fuque/PLCEXPAND/Evidencia/esp32 pinout.png

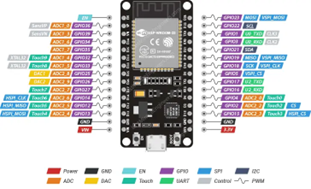
Evidencia/esp32 pinout.png
