fuque/PLCEXPAND/Evidencia/esquema final tarjeta.jpg

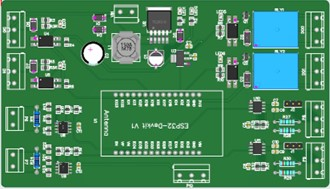
Evidencia/esquema final tarjeta.jpg
