fuque/PLCEXPAND/README.md

# PLCEXPAND
Diseño e implementación de un módulo de expansión de entradas digitales/analógicas para controlador lógico programable con comunicación modbus

Autores:

Andrés Camilo Fuquen Gil

Samir Andrés Velasco Niño

                        Escuela de Ingenierías Eléctrica, Electrónica y de Telecomunicaciones

                                          Universidad Industrial de Santander

                                                    Bucaramanga 2024
