fuque/PLCEXPAND/Entregables/Diapositivas Sustentación.pdf

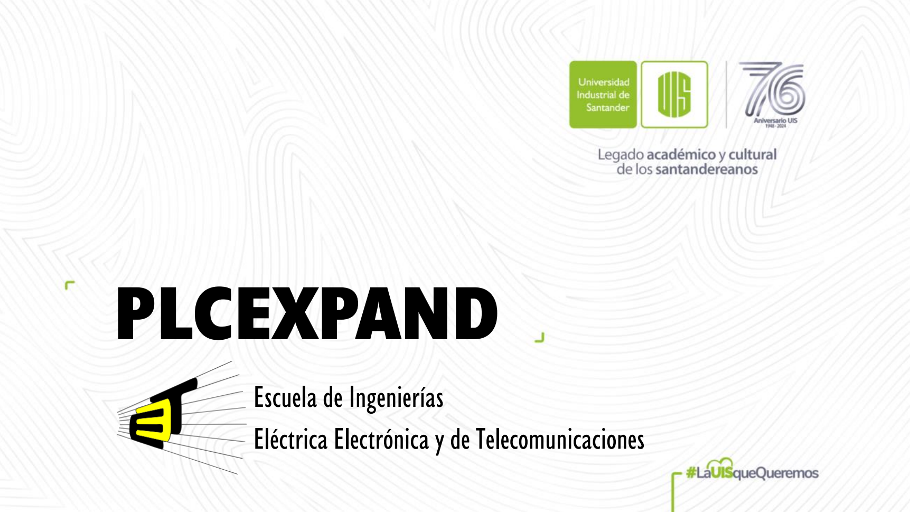
[picture p3: page 1]

# PLCEXPAND

# Escuela de Ingenierías

# Eléctrica Electrónica y de Telecomunicaciones

# AUTORES

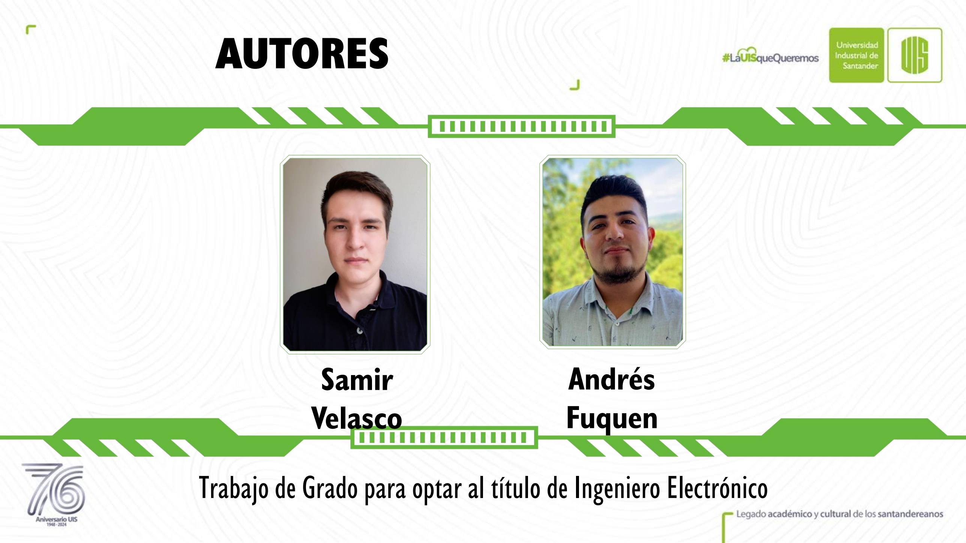
[picture p4: page 2]

# Samir Velasco

# Trabajo de Grado para optar al título de Ingeniero Electrónico

# Andrés Fuquen

# ORDEN DEL DÍA

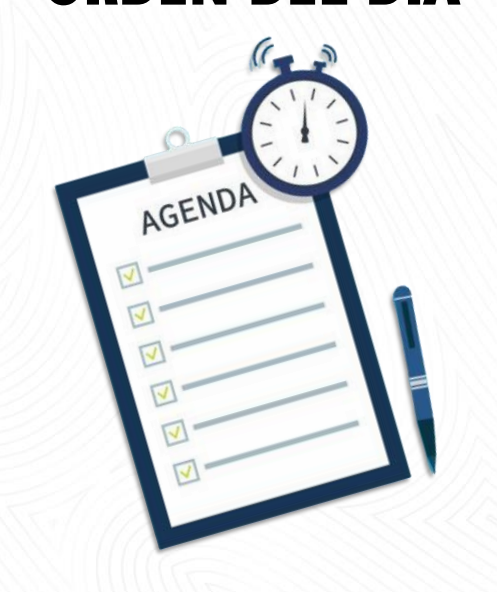
[picture p5: figure]

## - INTRODUCCÓN

## - OBJETIVO GENERAL

## - OBJETIVOS ESPECÍFICOS

## - METOLOGÍA

## - EJECUCIÓN Y RESULTADOS

## ✓ DISEÑO DE LA TARJETA ELECTÓNICA

## ✓ SELECCIÓN DE COMPONENTES

## ✓ IMPLEMENTACIÓN Y VALIDACIÓN

## - CARACTERÍSTICAS DEL COMPONENTE

## - PRESUPUESTO

## - CONCLUSIONES

## - REFERENCIAS BIBLIOGRÁFICAS

# INTRODUCCIÓN

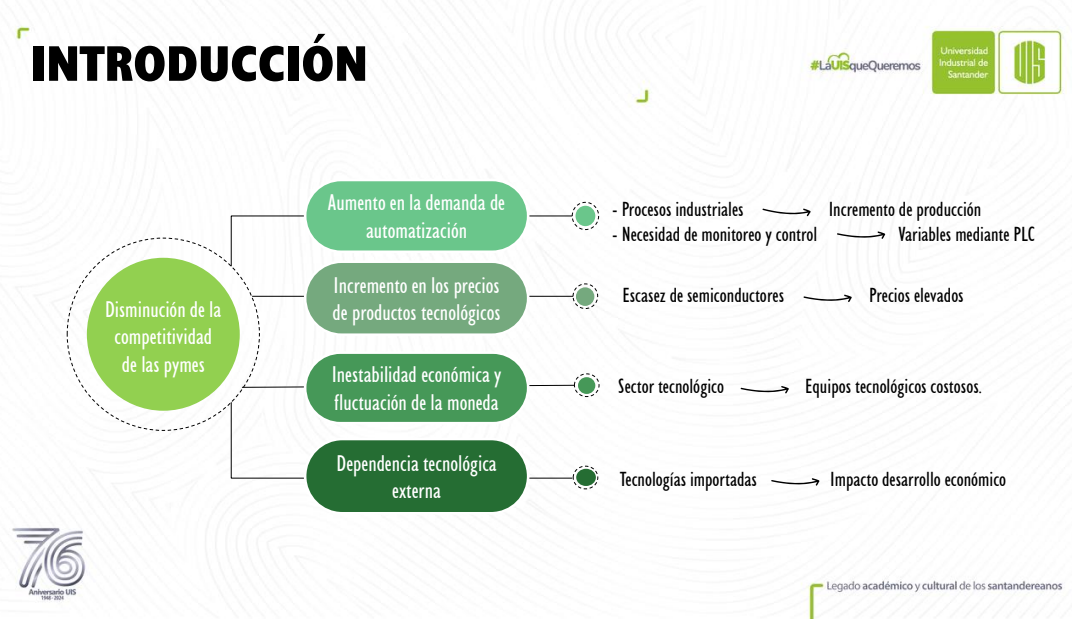
[picture p6: page 4]
Escasez de semiconductores; Precios elevados; - Procesos industriales; Incremento de producción; - Necesidad de monitoreo y control; Variables mediante PLC; Dependencia tecnológica; externa; Tecnologías importadas; Impacto desarrollo económico; Sector tecnológico; Equipos tecnológicos costosos.

Aumento en la demanda de
automatización

Incremento en los precios
de productos tecnológicos

Disminución de la
competitividad
de las pymes

Inestabilidad económica y
fluctuación de la moneda

# OBJETIVO GENERAL

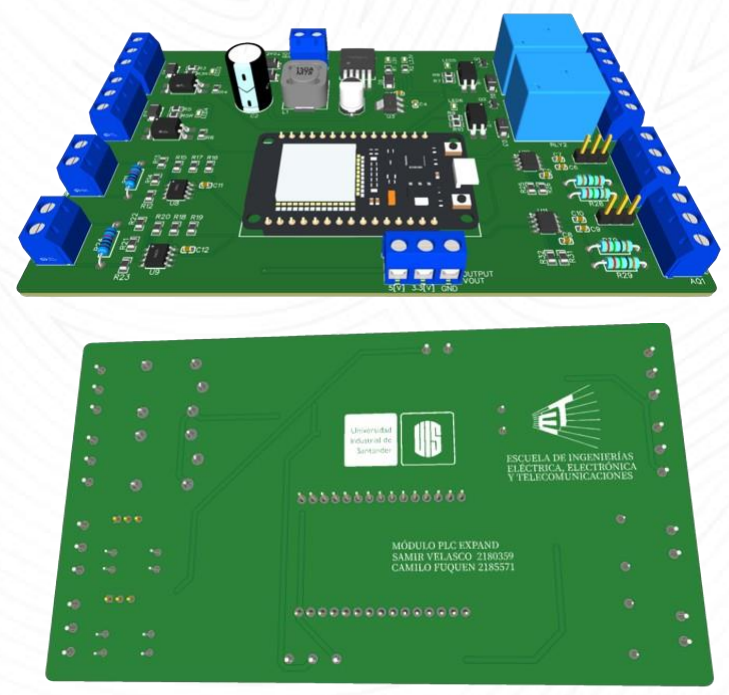
[picture p7: figure]

## Diseñar e Implementar un prototipo para la expansión de entradas digitales y analógicas para un Controlador Lógico Programable (PLC) con

comunicación Modbus.

# OBJETIVOS ESPECÍFICOS

### Diseñar un circuito electrónico basado en microcontrolador que permita

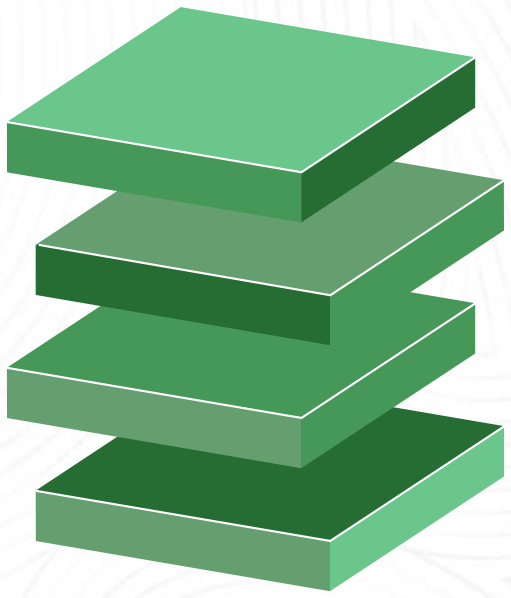
[picture p8: figure]

manejar entradas y salidas analógicas y digitales.

### Seleccionar los componentes electrónicos adecuados para la implementación de la tarjeta electrónica, basado en criterios económicos, de disponibilidad y

compatibilidad.

### Implementar, mediante MODBUS, la comunicación entre una tarjeta electrónica y un Controlador Lógico Programable (PLC) mediante el uso del

software TIA Portal.

### Validar la lectura digital/analógica con el Controlador Lógico Programable

(PLC) del módulo expansor mediante comunicación Modbus.

1

2

3

4

# METODOLOGÍA

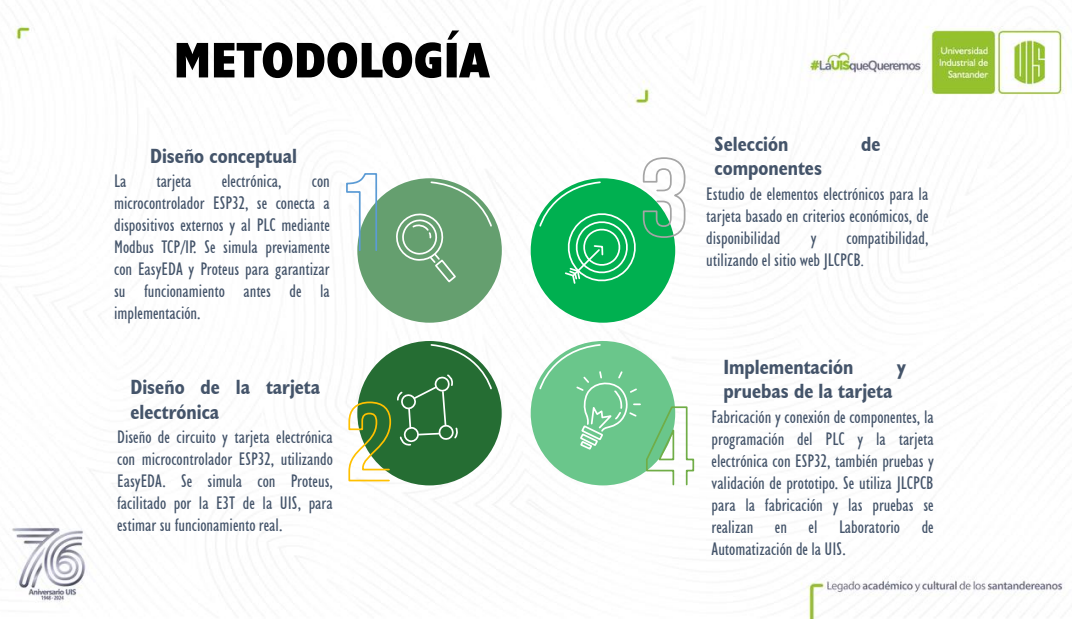
[picture p9: page 7]
tarjeta; electrónica,; con; funcionamiento; antes; y tarjeta electrónica; , utilizando; compatibilidad,; realizan; Laboratorio; Diseño conceptual; Selección

componentes
Estudio de elementos electrónicos para la
tarjeta basado en criterios económicos, de
disponibilidad
utilizando el sitio web JLCPCB

microcontrolador ESP32
dispositivos externos
Modbus TCP/IP. Se simula previamente
con EasyEDA
implementación

, se conecta
y al PLC mediante

y Proteus para garantizar

Implementación
pruebas de la tarjeta
Fabricación
programación del PLC
electrónica con ESP32
validación de prototipo
para la fabricación
Automatización de la UIS

Diseño de la tarjeta
electrónica
Diseño de circuito
con microcontrolador ESP32
EasyEDA
facilitado por la
estimar su funcionamiento real

y conexión de componentes, la

y la tarjeta
, también pruebas
. Se utiliza JLCPCB
y las pruebas se

. Se simula con Proteus,

T de la UIS, para

# EJECUCIÓN Y RESULTADOS

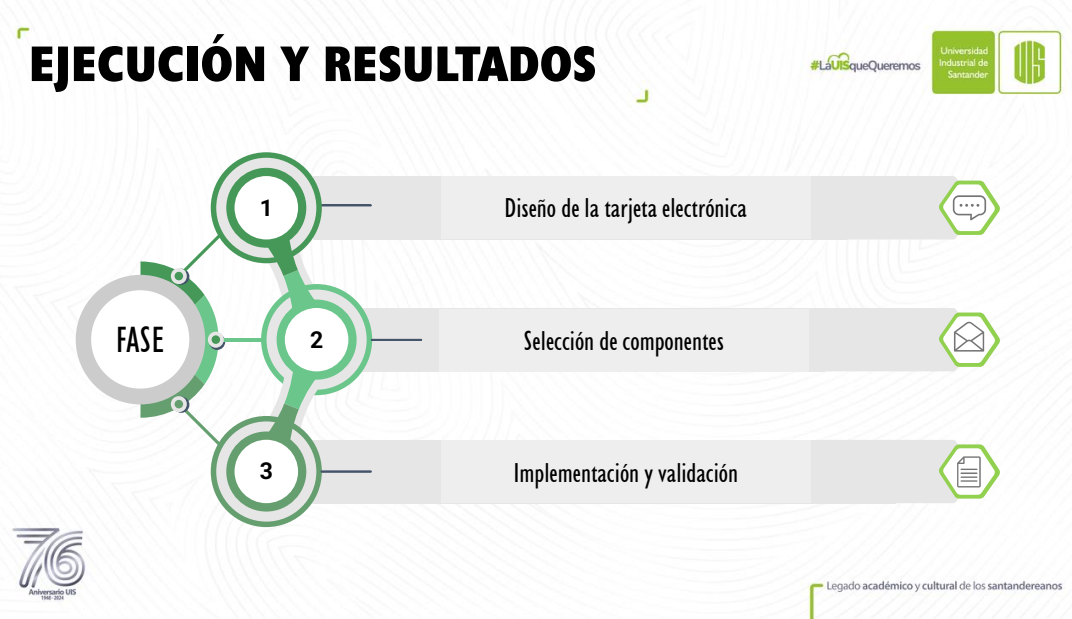
[picture p10: page 8]
3 Implementación y validación; FASE

Diseño de la tarjeta electrónica

Selección de componentes

DISEÑO | DE | LA | TARJETA

# ELECTRÓNICA

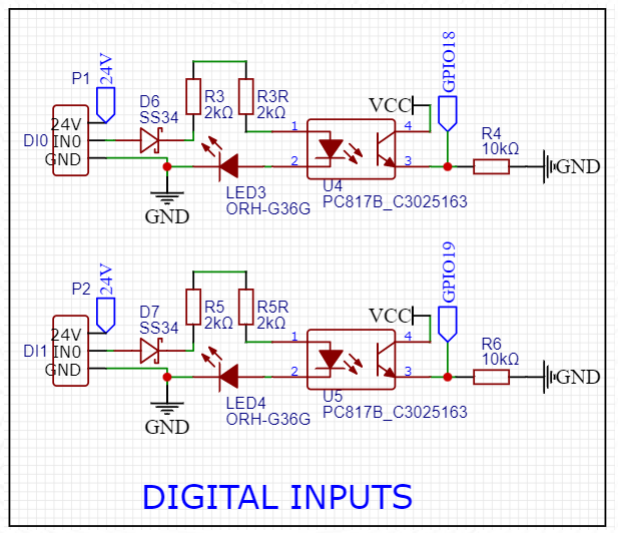
[picture p11: figure]
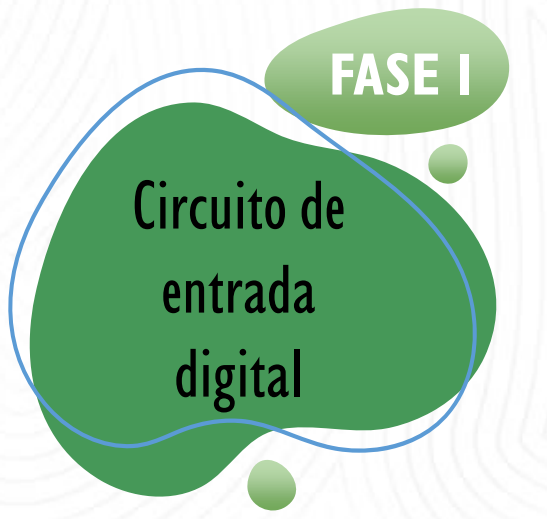
[picture p12: figure]
FASE 1; Circuito de; entrada; digital

DISEÑO | DE | LA | TARJETA

# ELECTRÓNICA

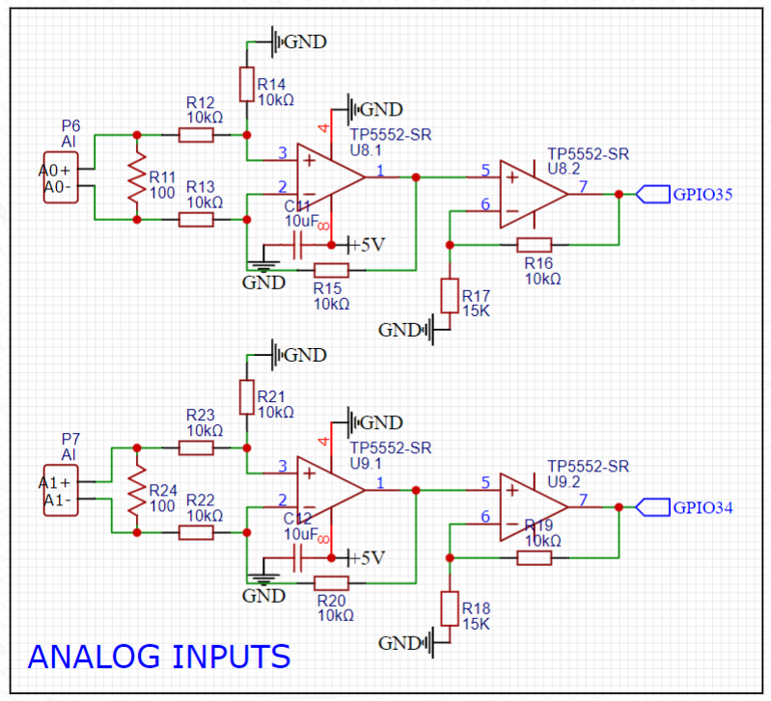
[picture p13: figure]
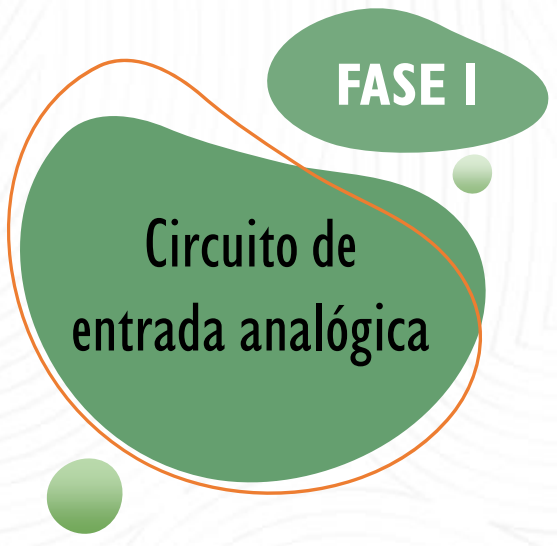
[picture p14: figure]
FASE 1; Circuito de; entrada analógica

DISEÑO | DE | LA | TARJETA

# ELECTRÓNICA

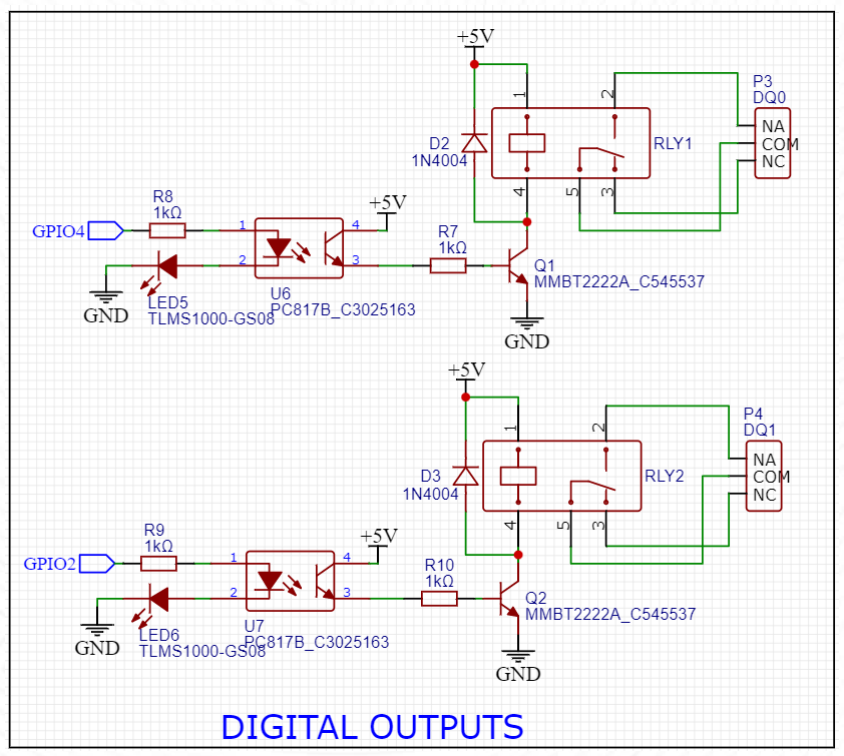
[picture p15: figure]
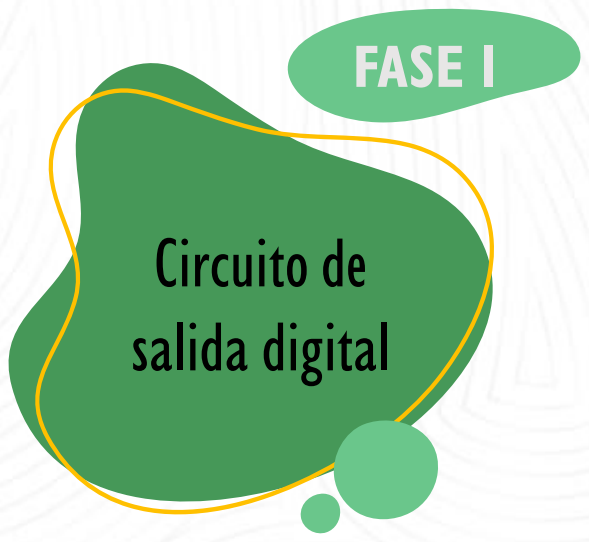
[picture p16: figure]
FASE 1; Circuito de; salida digital

DISEÑO | DE | LA | TARJETA

# ELECTRÓNICA

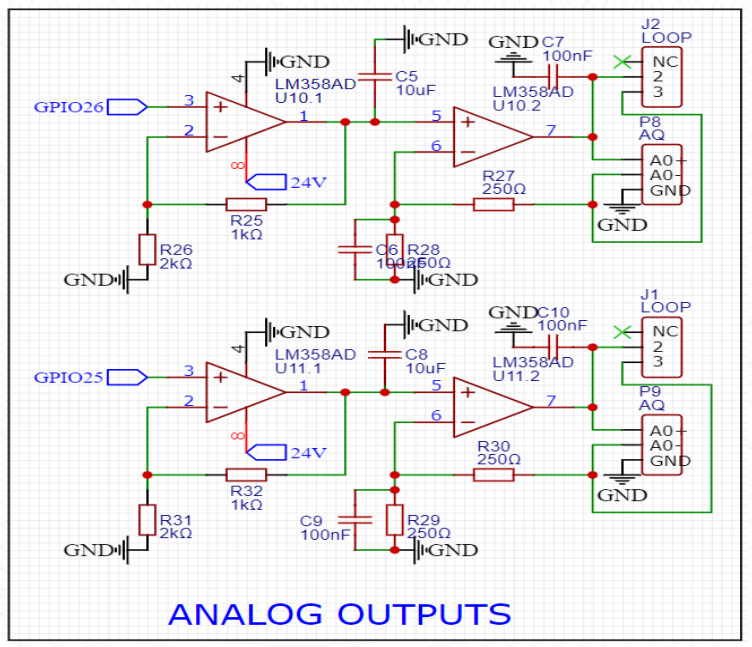
[picture p17: figure]
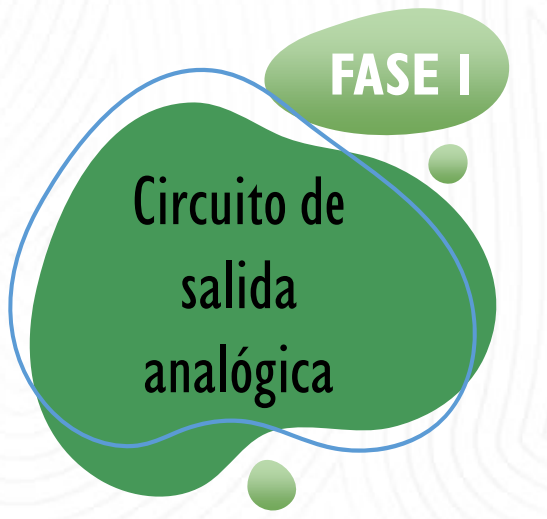
[picture p18: figure]
FASE 1; Circuito de; salida; analógica

DISEÑO | DE | LA | TARJETA

# ELECTRÓNICA

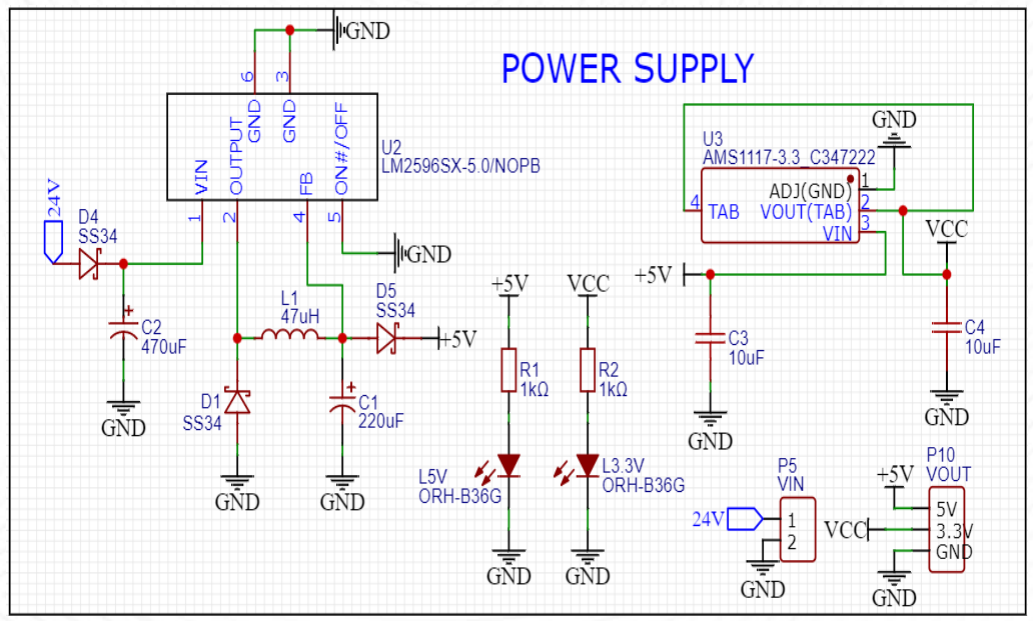
[picture p19: figure]
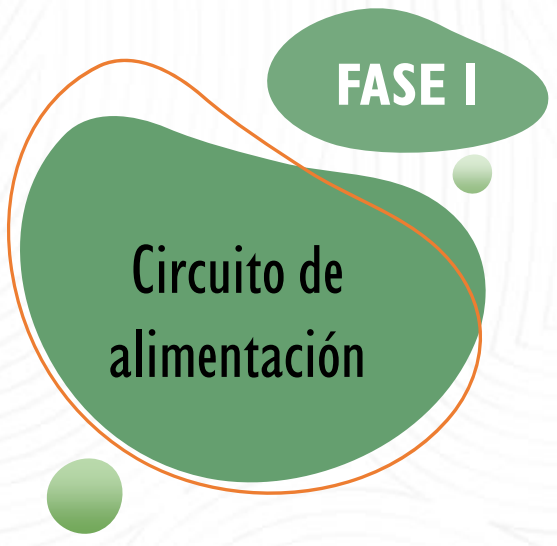
[picture p20: figure]
FASE 1; Circuito de; alimentación

# SELECCIÓN DE COMPONENTES

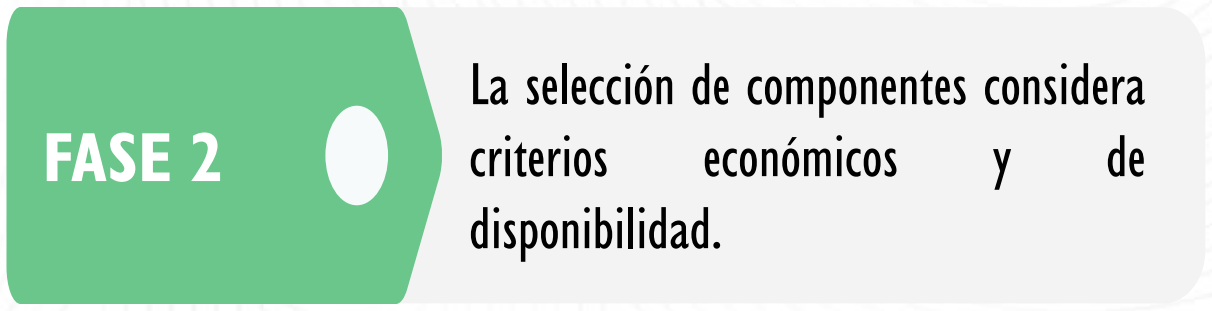
[picture p21: figure]
FASE 2; La selección de componentes considera; criterios; económicos; disponibilidad.

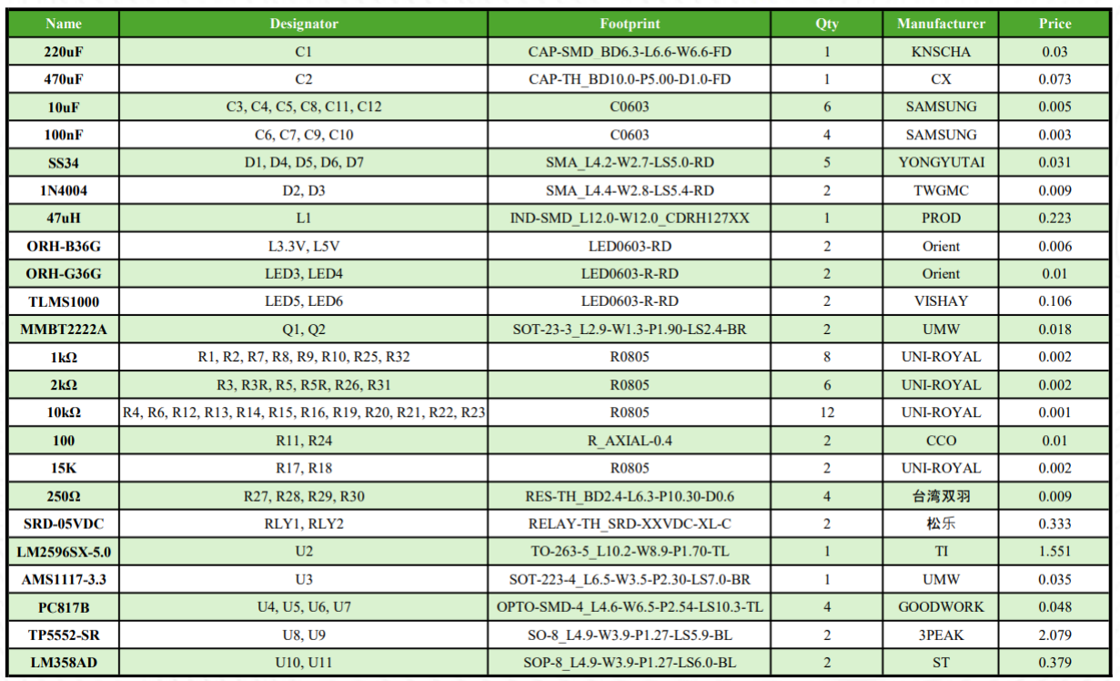
[picture p22: figure]

# IMPLEMENTACIÓN Y VALIDACIÓN

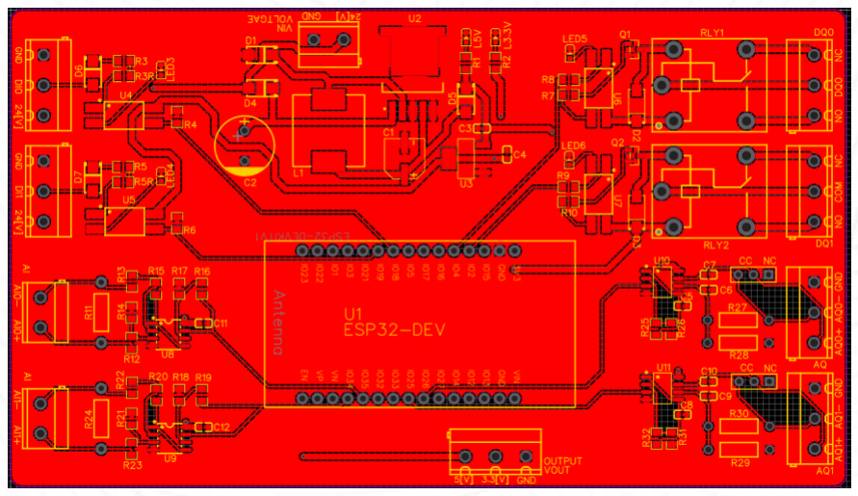
[picture p23: figure]
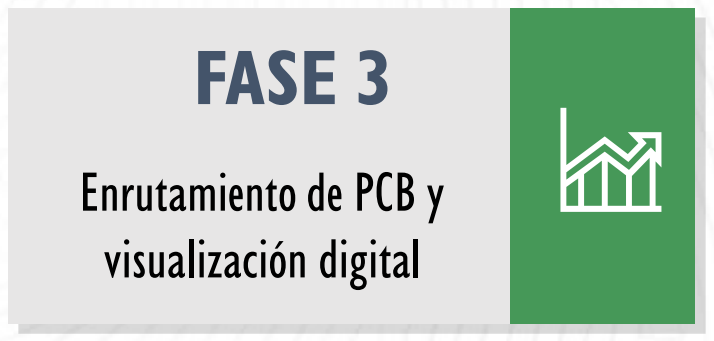
[picture p24: figure]
Enrutamiento de PCB y; visualización digital; FASE 3
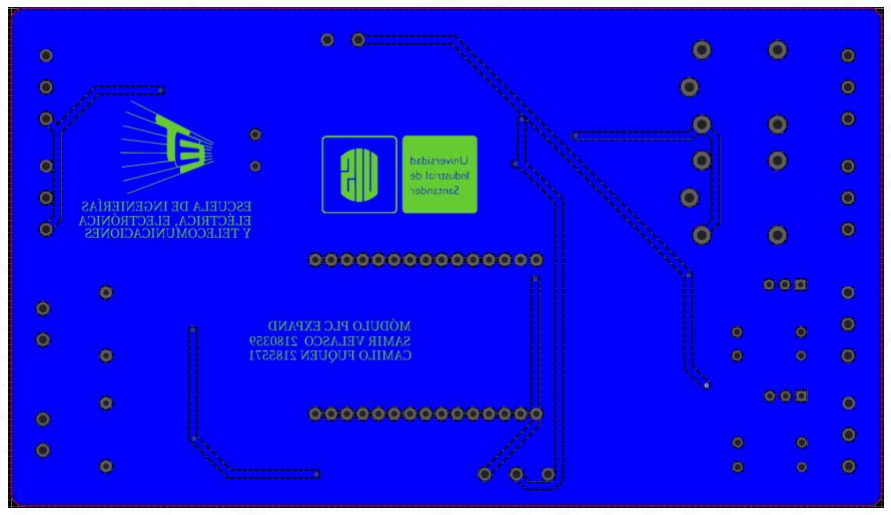
[picture p25: figure]

# IMPLEMENTACIÓN Y VALIDACIÓN

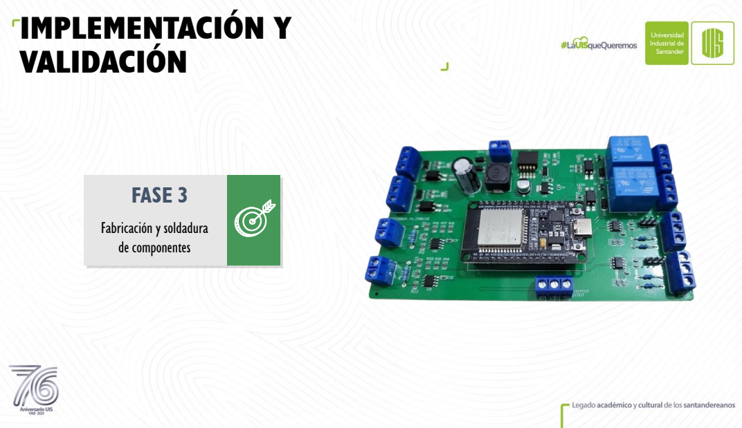
[picture p26: page 17]
Fabricación y soldadura; de componentes; FASE 3

# IMPLEMENTACIÓN Y VALIDACIÓN

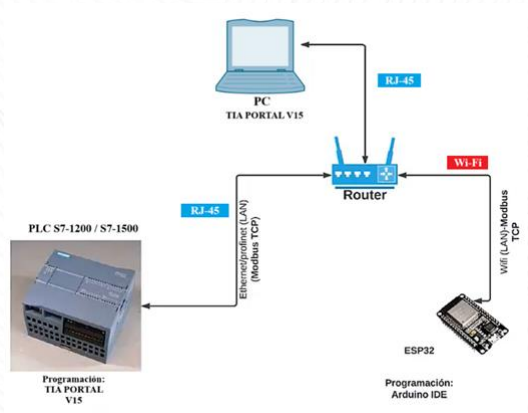
[picture p27: figure]
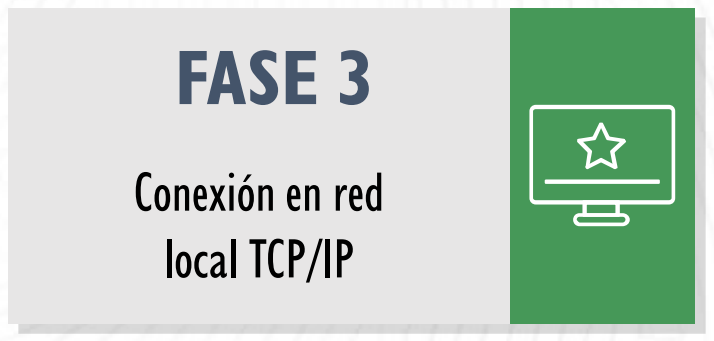
[picture p28: figure]
Conexión en red; local TCP/IP; FASE 3

# IMPLEMENTACIÓN Y VALIDACIÓN

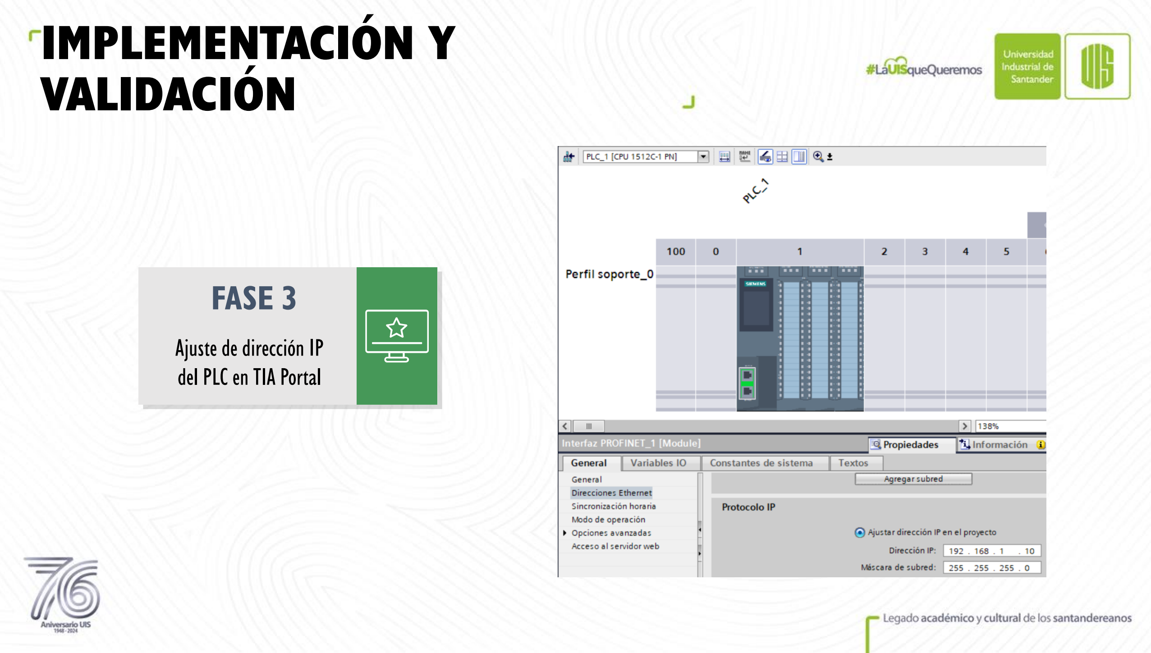
[picture p29: page 19]

### Ajuste de dirección IP

### del PLC en TIA Portal

## FASE 3

# IMPLEMENTACIÓN Y VALIDACIÓN

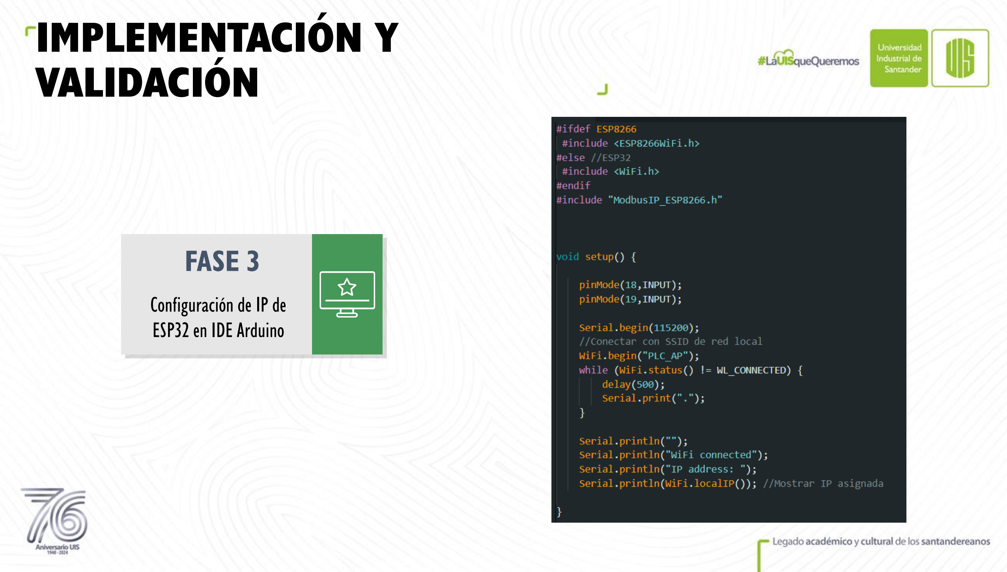
[picture p30: page 20]

### Configuración de IP de

### ESP32 en IDE Arduino

## FASE 3

# IMPLEMENTACIÓN Y VALIDACIÓN

### Ajuste de dirección IP

### del PLC en TIA Portal

## FASE 3

# IMPLEMENTACIÓN Y VALIDACIÓN

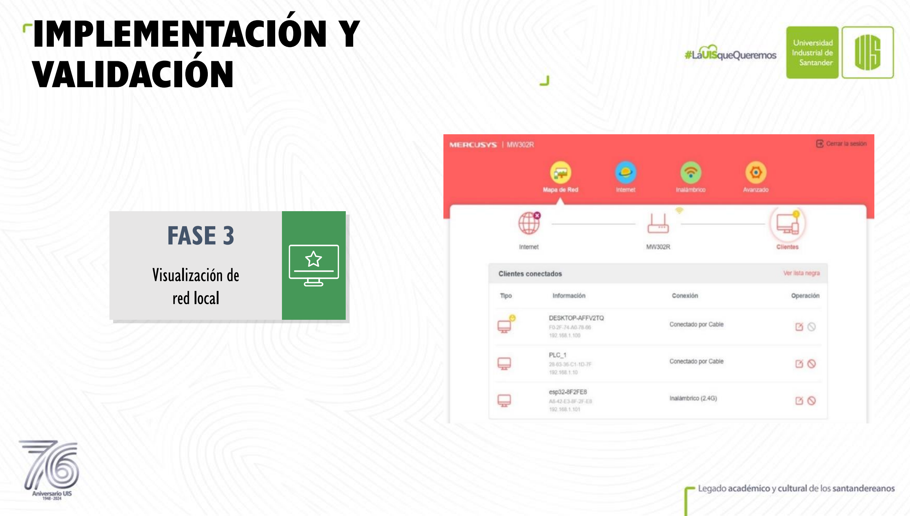
[picture p31: page 22]

### Visualización de red local

## FASE 3

# IMPLEMENTACIÓN Y VALIDACIÓN

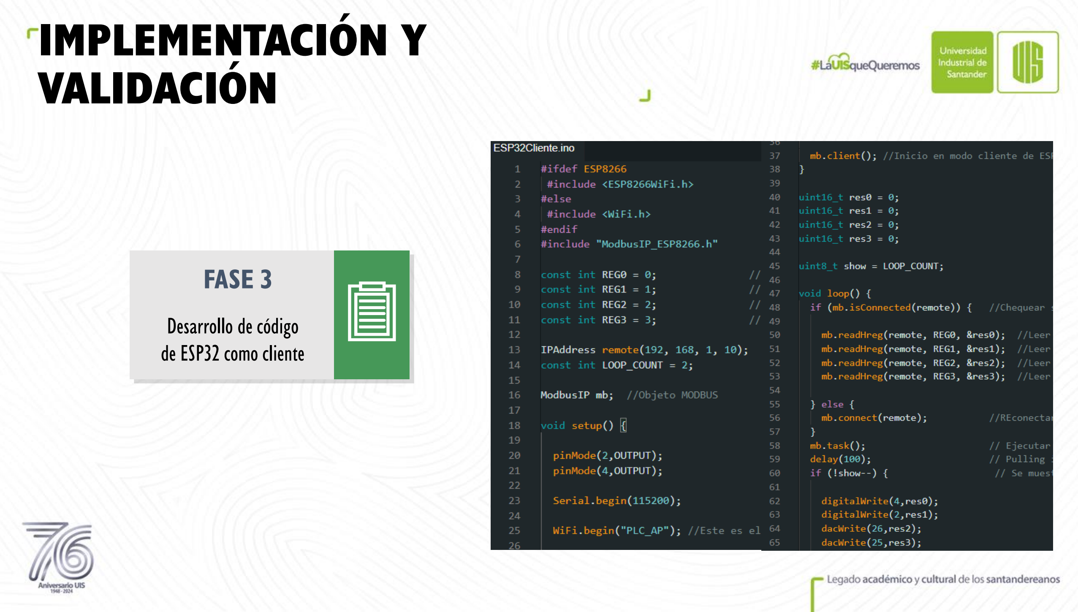
[picture p32: page 23]

### Desarrollo de código de ESP32 como cliente

## FASE 3

# IMPLEMENTACIÓN Y VALIDACIÓN

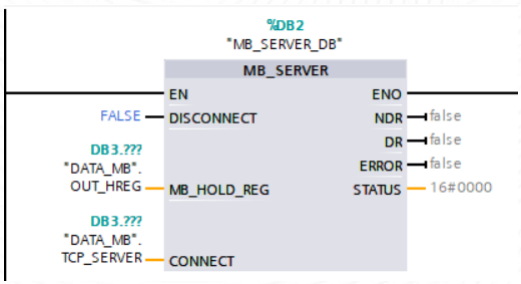
[picture p33: figure]
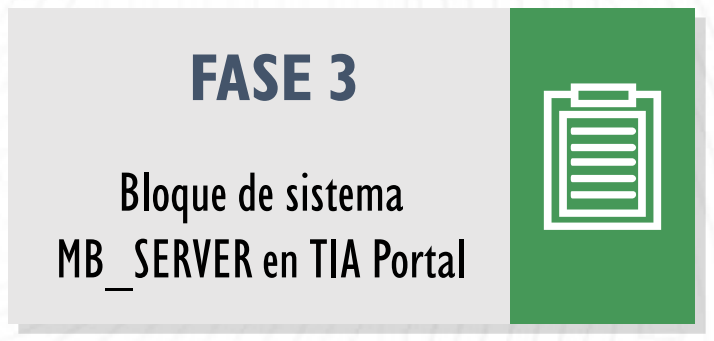
[picture p34: figure]
Bloque de sistema; MB_SERVER en TIA Portal; FASE 3

# IMPLEMENTACIÓN Y VALIDACIÓN

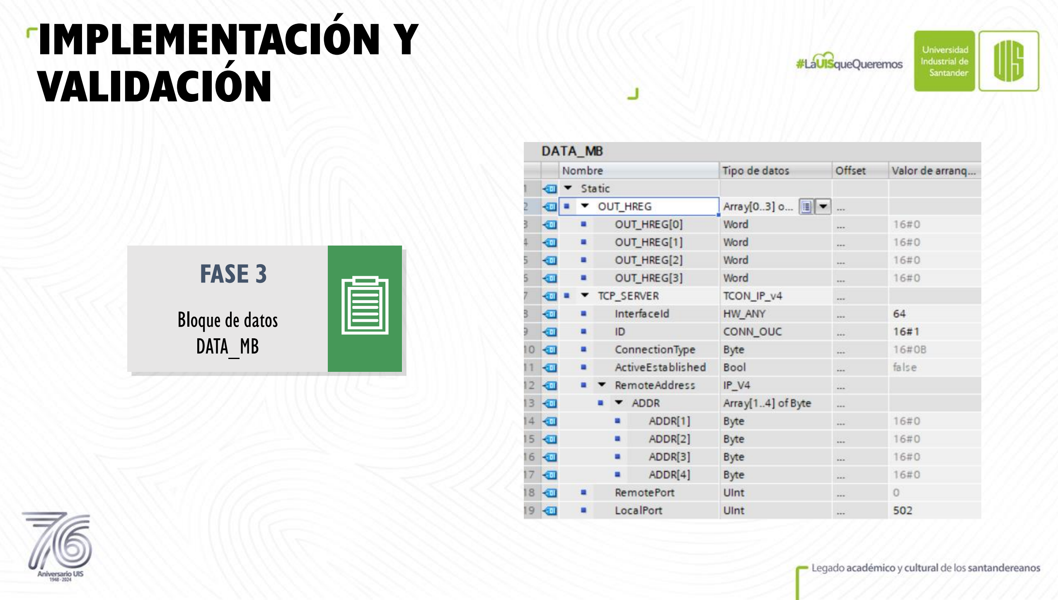
[picture p35: page 25]

### Bloque de datos

### DATA_MB

## FASE 3

# IMPLEMENTACIÓN Y VALIDACIÓN

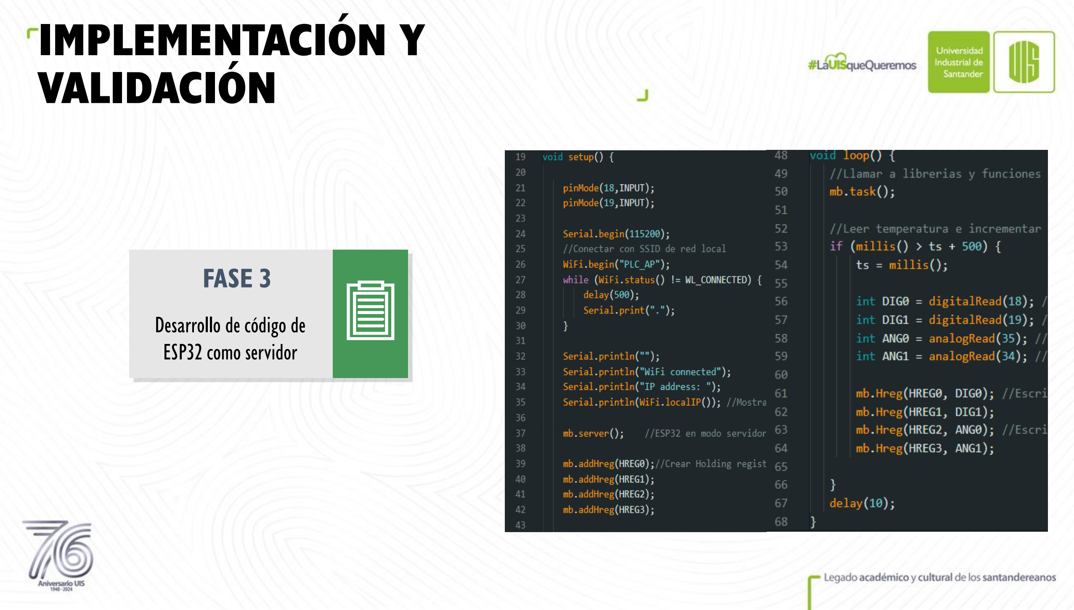
[picture p36: page 26]

### Desarrollo de código de ESP32 como servidor

## FASE 3

# IMPLEMENTACIÓN Y VALIDACIÓN

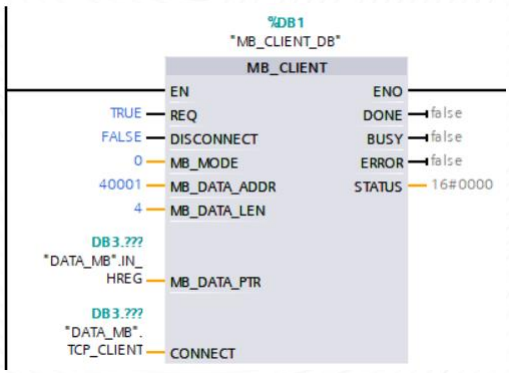
[picture p37: figure]
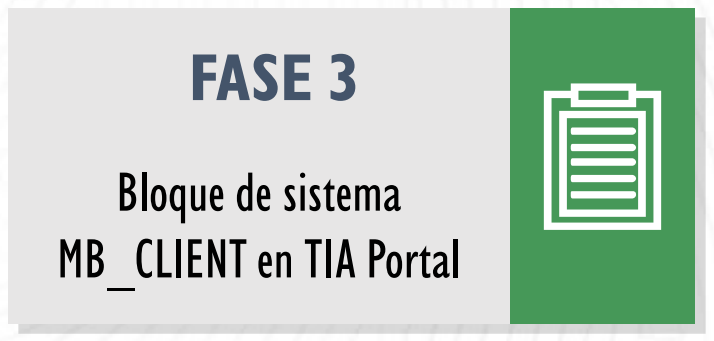
[picture p38: figure]
Bloque de sistema; MB_CLIENT en TIA Portal; FASE 3

# IMPLEMENTACIÓN Y VALIDACIÓN

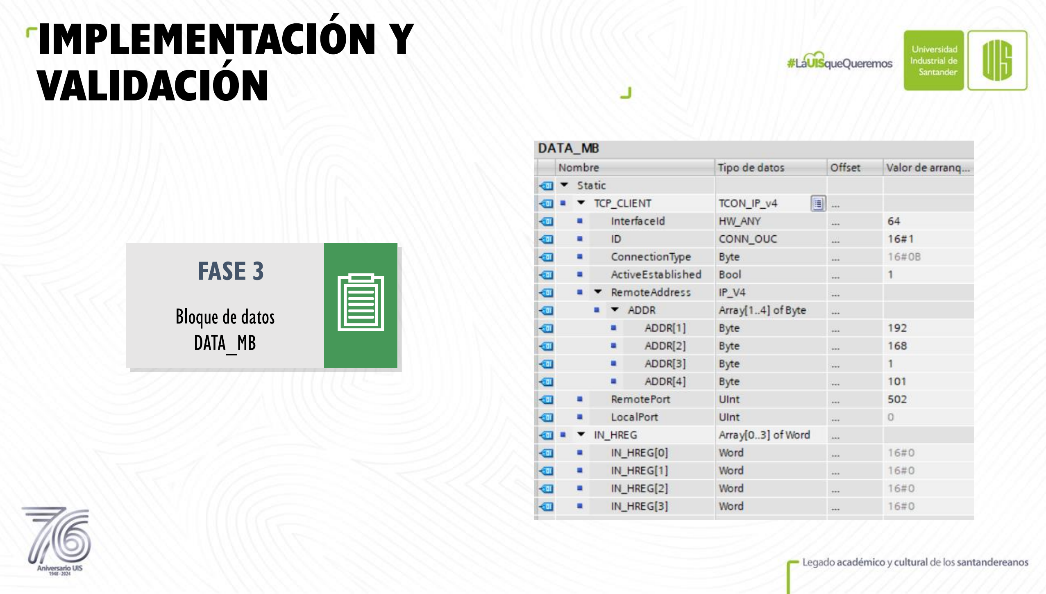
[picture p39: page 28]

### Bloque de datos

### DATA_MB

## FASE 3

# IMPLEMENTACIÓN Y VALIDACIÓN

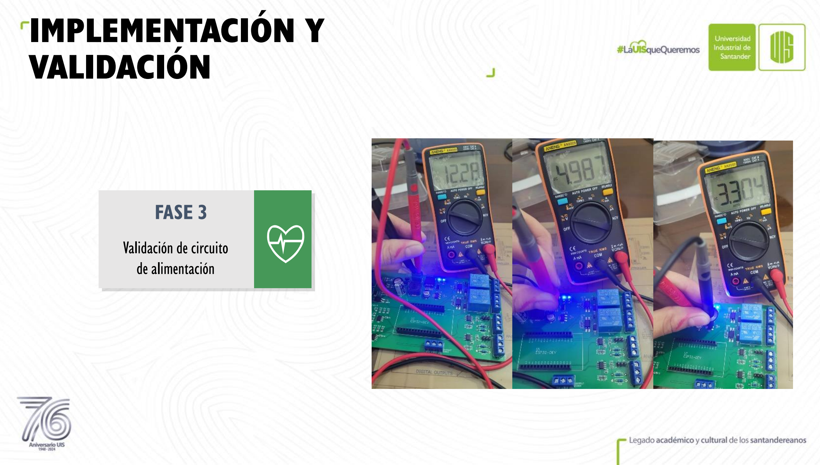
[picture p40: page 29]

### Validación de circuito de alimentación

## FASE 3

# IMPLEMENTACIÓN Y VALIDACIÓN

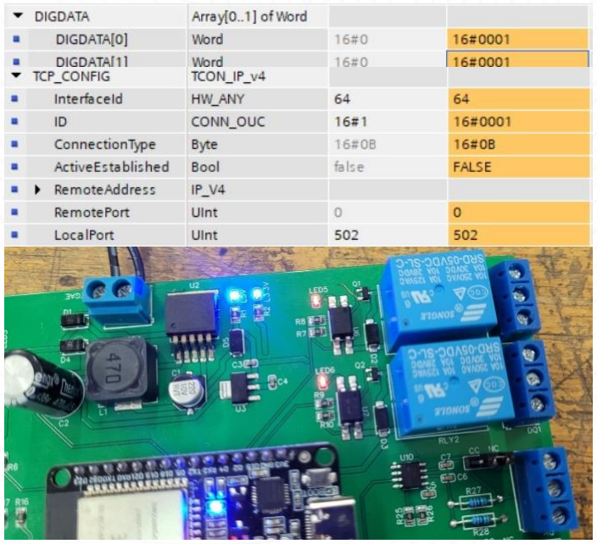
[picture p41: figure]
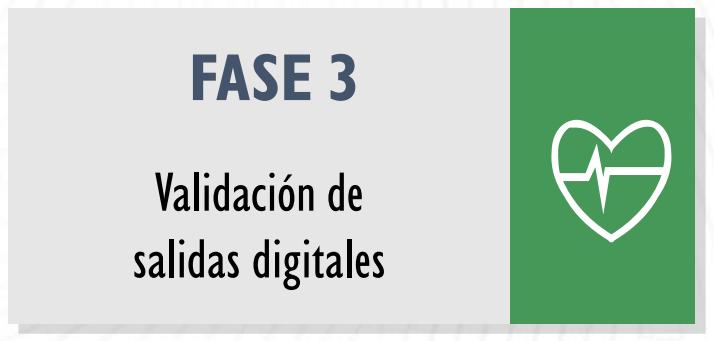
[picture p42: figure]
Validación de; salidas digitales; FASE 3

# IMPLEMENTACIÓN Y VALIDACIÓN

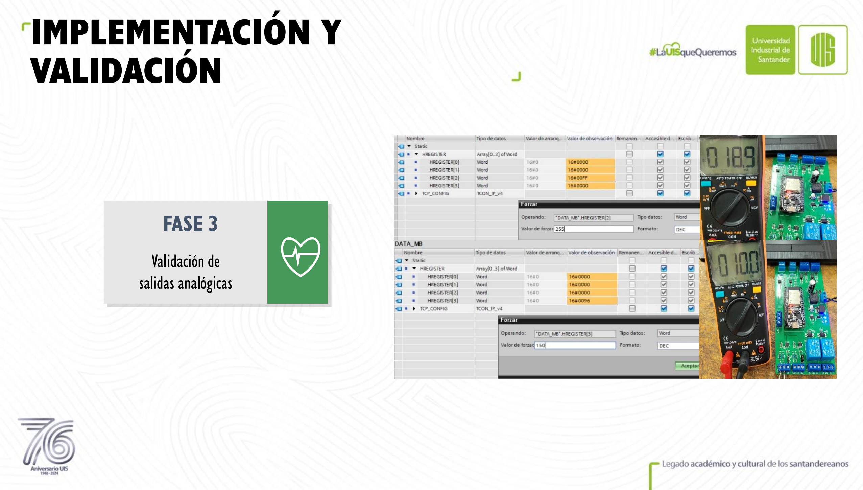
[picture p43: page 31]

### Validación de salidas analógicas

## FASE 3

# IMPLEMENTACIÓN Y VALIDACIÓN

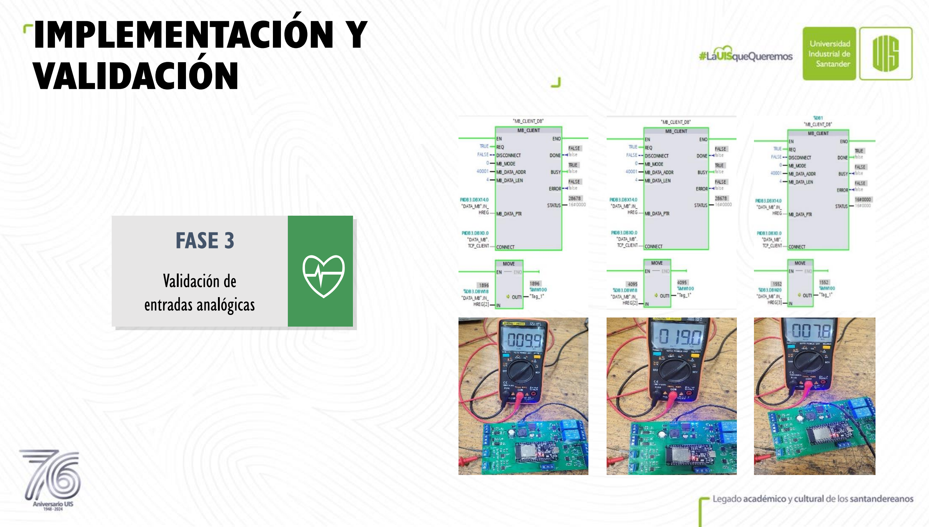
[picture p44: page 32]

### Validación de entradas analógicas

## FASE 3

# IMPLEMENTACIÓN Y VALIDACIÓN

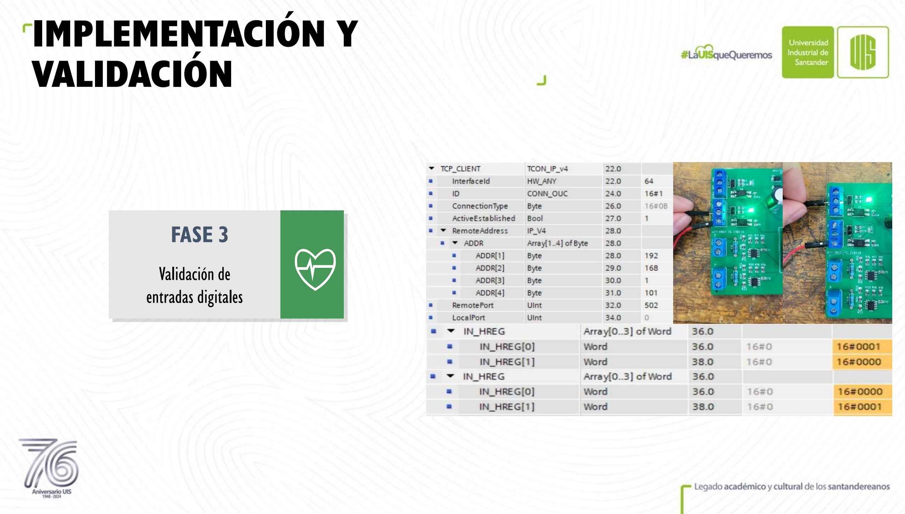
[picture p45: page 33]

### Validación de entradas digitales

## FASE 3

# CARACTERÍSTICAS DEL COMPONENTE

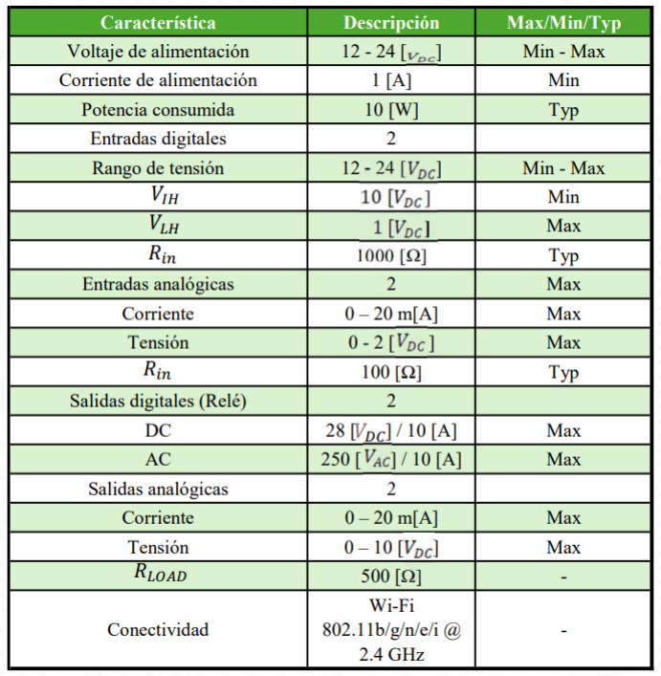
[picture p46: figure]

# PRESUPUESTO

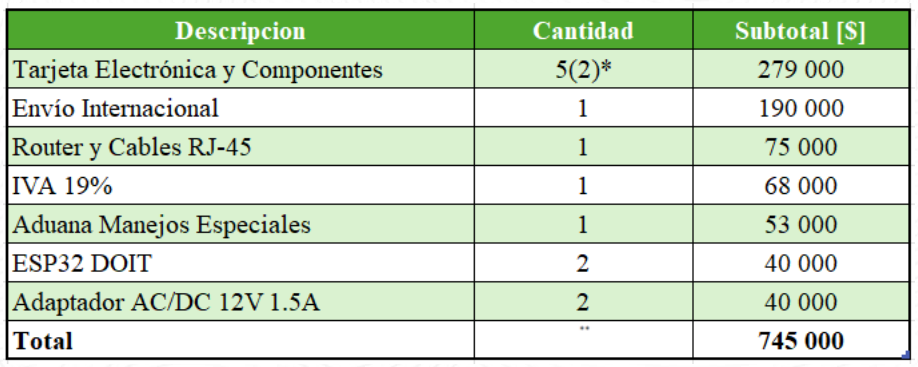
[picture p47: figure]

# CONCLUSIONES

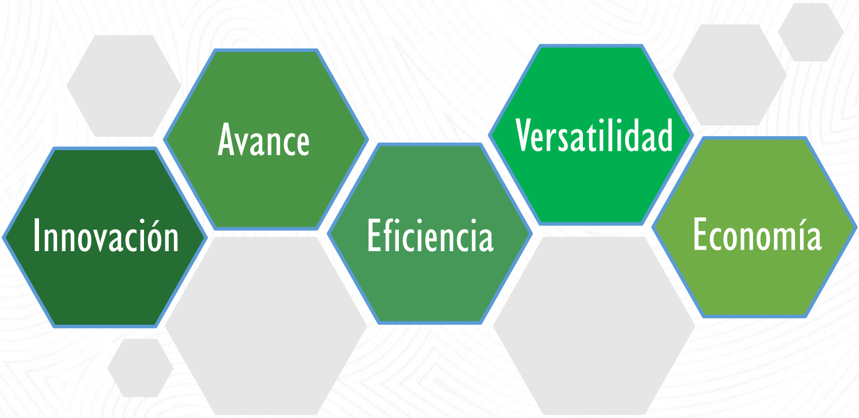
[picture p48: figure]
Eficiencia; Avance; Innovación; Versatilidad; Economía

# REFERENCIAS BIBLIOGRÁFICAS

Acosta, J. (5 de Noviembre de 2023). La resistencia a la reindustrialización para el desarrollo. Obtenido de Razón Pública: https://razonpublica.com/la-resistencia-la-reindustrializacion-

desarrollo/

Arduino. (2024). Software | Arduino. Obtenidode https://www.arduino.cc/en/software
Bolton, | W. | (2015). | Programmable | Logic | Controllers | (Sixth | Edition | ed.). | Oxford: | Elsevier. | Obtenido | de

https://www.academia.edu/94987128/William_Bolton_Programmable_Logic_Controllers_Sixth_Edition_Newnes_2015_

Borja Calvo, L. (2019). Adquisición de datos desde plataforma IOT2040. Protocolos Modbus/TCP y OPC UA. Universidad del País Vasco: Tesis de grado. Obtenido de

https://addi.ehu.es/bitstream/handle/10810/36491/TFG-%20Borja%20Calvo.pdf?sequence=2&isAllowed=y

Cajamarca, I. (13 de Noviembre de 2021). Industrias estarán frenadas hasta 2023 ante la crisis generada por la escasez de chips. Obtenido de Diario la República:

https://www.larepublica.co/internet-economy/industrias-estaran-frenadas-hasta-2023-ante-la-crisis-generada-por-la-escasez-de-chips-3261411

Creus, A. (2010). Instrumentación Industrial (octavaedicióned.).Alfaomega Grupo Editor S.A.

EasyEDA. (2024). Simuladorde circuitos ydiseño de circuitos impresos online. Obtenido dehttps://easyeda.com/es

Electrónico, T. (15 de Marzo de 2022). Comunicación MODBUS TCP(Servidor-Cliente) entrePLC Siemens S7-1200 yESP32. Obtenidode YouTube: https://youtu.be/CzEdDJVsmAM

Emelianov. (2024). Most complete Modbus library forArduino. Obtenido de GitHub: https://github.com/emelianov/modbus-esp8266

Espressif Systems. (2024). ESP32 Wi-Fi & BluetoothSOC. Obtenido dehttps://www.espressif.com/en/products/socs/esp32

IPSON.nl. (s.f.). Opamp basics - Technology forArt and Education. Obtenido de https://www.ipson.nl/opamp-circuit-examples/

JLCPCB. (2024).PCB Prototype & PCB Fabrication Manufacturer - JLCPCB. Obtenido de https://jlcpcb.com/

Joan. (2024). Tutorial del optoacoplador con circuito deE/S. Obtenido de Electrónica Joan: https://electrojoan.com/tutorial-del-optoacoplador-con-circuito-de-e-s/

Labcenter Electronics. (2024). PCB Design and Circuit Simulator Software -Proteus. Obtenido de https://www.labcenter.com/

Lesmes, L. (31 de Enero de 2022). El impacto de la crisis de contenedores podría ir hasta 2023. Obtenido de Revista Portafolio: https://www.portafolio.co/revista-portafolio/el-

impacto-de-la-crisis-de-contenedores-podria-ir-hasta-2023-561156

Mandado, E., Acevedo, J. M., Fernandez, C., & Armesto, J. (2009). Autómatas programables y sistemas de automatización. MARCOMBO, S.A. Obtenido de

https://www.academia.edu/43582464/Automatas_Programables_y_Sistemas_de_Automatizacion_Parte

MERCUSYS Technologies Co. (2024). Welcome to MERCUSYS. Obtenido de https://www.mercusys.com/co/

Mordor Intelligence. (2024). Mercado PLC. Obtenido de Mordor Intelligence: https://www.mordorintelligence.com/es/industry-reports/programmable-logic-

controller-plc-market

Sanchis, R., Romero, J., & Ariño, C. (2010). Automatización Industrial. España: Publicaciones de la Universitat Jaume I.

Schneider | Electric. | (2020). | Funciones | TCP/IP | Modbus. | Obtenido | de | Schneider | Electric: | https://product-help.schneider-

electric.com/ED/PowerTag/Smartlink_SIB/EDMS/DOCA0123ES/DOCA0123xx/Details_of_Modbus_Functions/Details_of_Modbus_Functions-

2.htm#XREF_D_SE_0060560_1

Siemens. (2024). TIA Portal - Siemens Global. Obtenido de https://www.siemens.com/global/en/products/automation/industry-software/automation-

software/tia-portal.html

WiAutomation. (2024). WiAutomation | Proveedorde repuestos de automatización. Obtenido de https://co.wiautomation.com/

https://www.freepik.com/

https://slidesgo.com/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

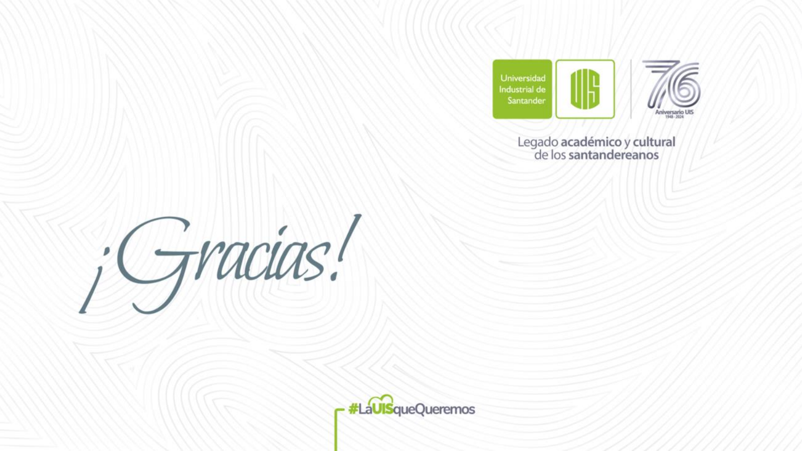
[picture p49: page 40]
