fuque/PLCEXPAND/Cálculos para pistas/ancho minimo.jpg

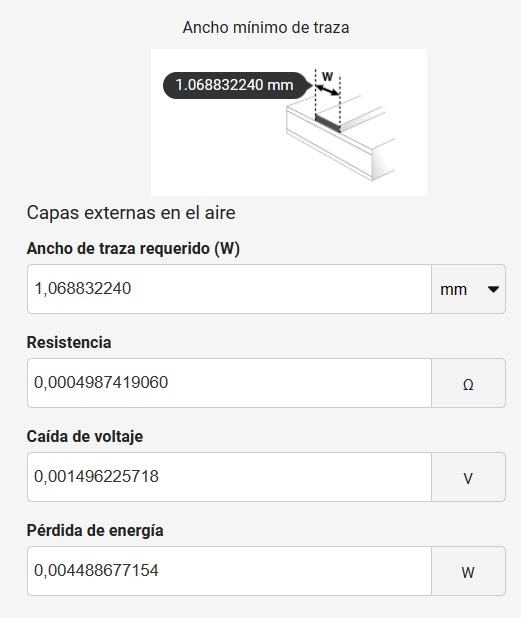
Cálculos para pistas/ancho minimo.jpg
