fuque/PLCEXPAND/Cálculos para pistas/espesor y longitud.jpg

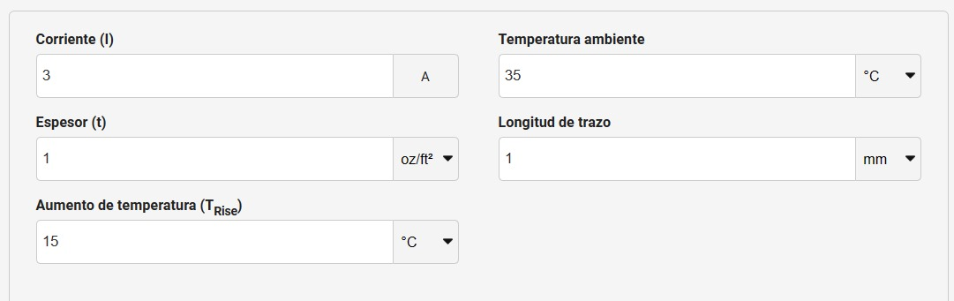
Cálculos para pistas/espesor y longitud.jpg
