fuque/PLCEXPAND/Cálculos para pistas/formula.jpg

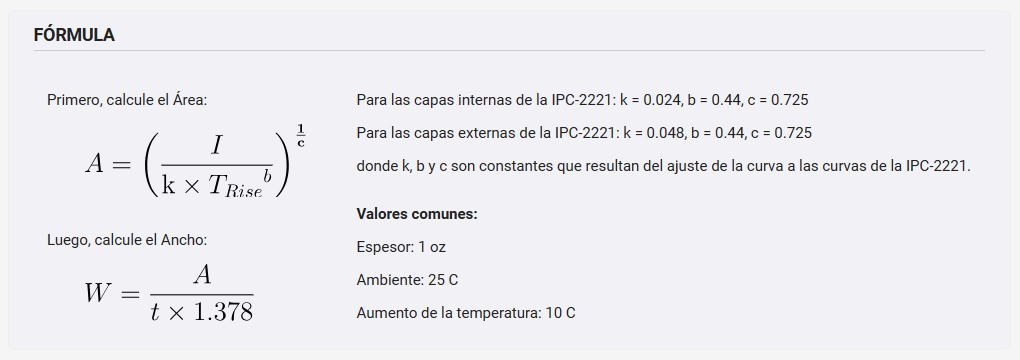
Cálculos para pistas/formula.jpg
