fuque/PLCEXPAND/Cálculos para pistas/tabla.jpg

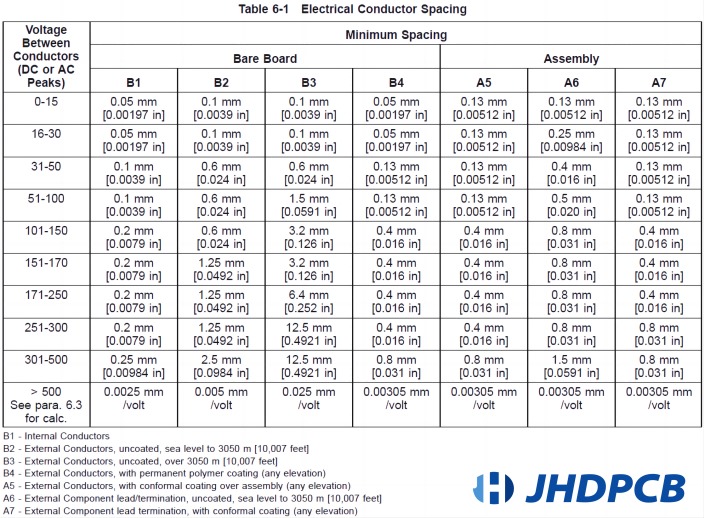
Cálculos para pistas/tabla.jpg
