fuque/PLCEXPAND/Evidencia/AI proteus.jpg

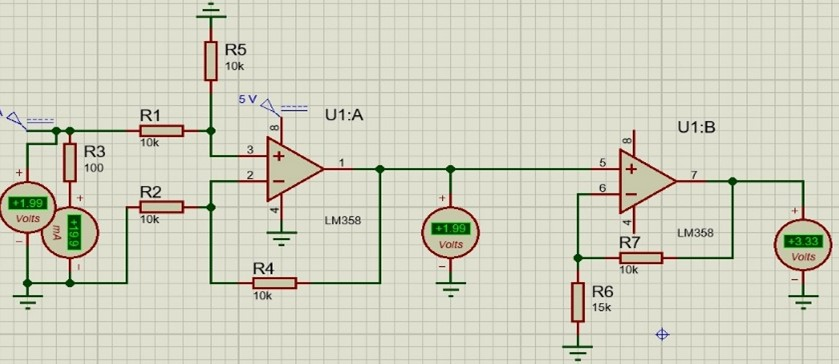
Evidencia/AI proteus.jpg
