fuque/PLCEXPAND/Evidencia/AO proteus.jpg

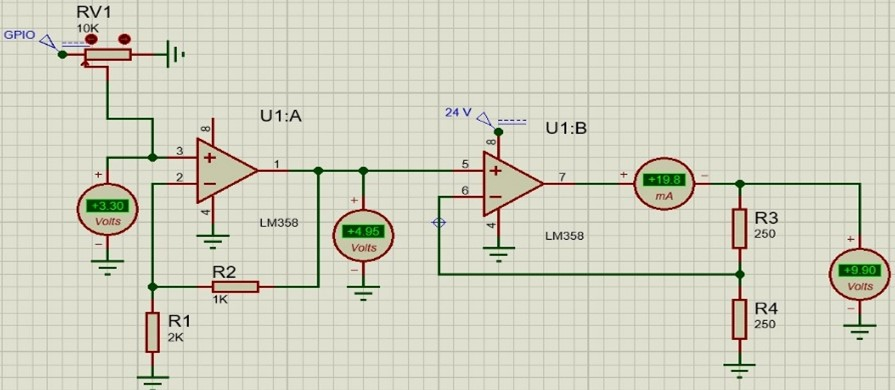
Evidencia/AO proteus.jpg
