fuque/PLCEXPAND/Evidencia/DI easyeda.png

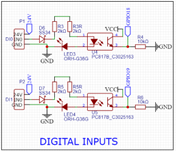
Evidencia/DI easyeda.png
