fuque/PLCEXPAND/Evidencia/DI proteus.jpg

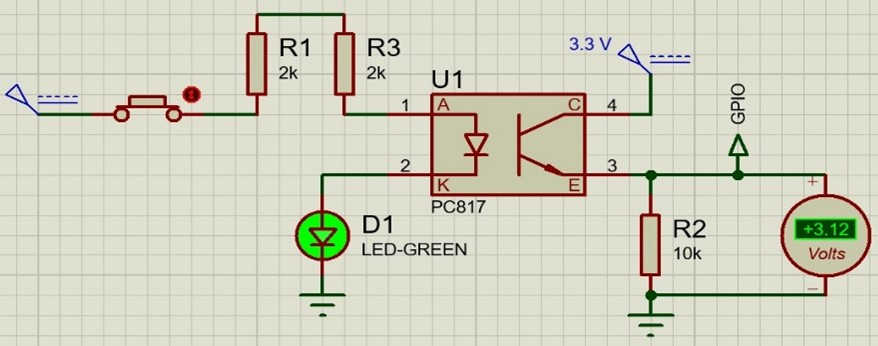
Evidencia/DI proteus.jpg
