fuque/PLCEXPAND/Evidencia/DO proteus.jpg

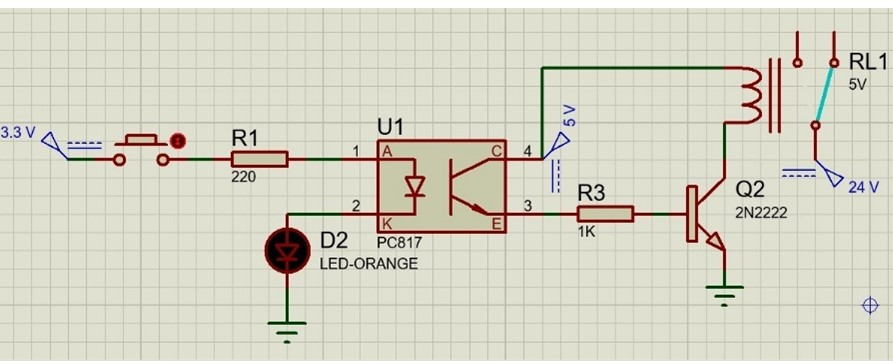
Evidencia/DO proteus.jpg
