fuque/PLCEXPAND/Evidencia/esquema de un PLC.png

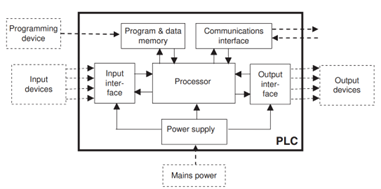
Evidencia/esquema de un PLC.png
