fuque/PLCEXPAND/Evidencia/tarjeta finalizada.png

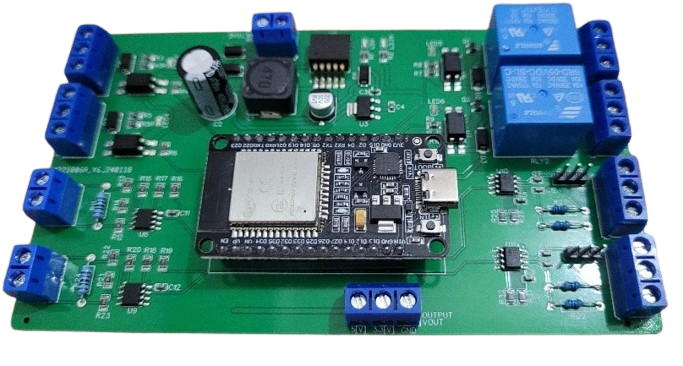
Evidencia/tarjeta finalizada.png
