fuque/PLCEXPAND/Evidencia/tarjeta fisica sin terminar.png

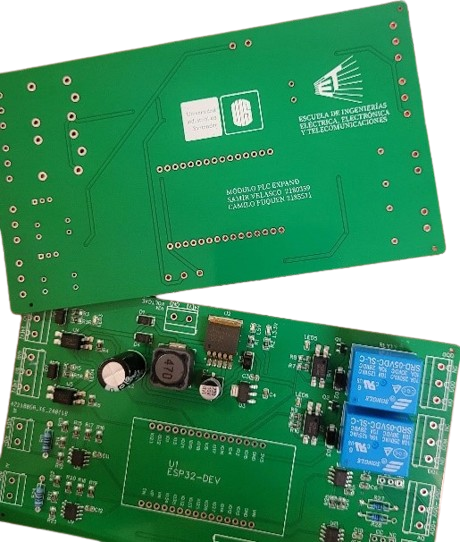
Evidencia/tarjeta fisica sin terminar.png
