fuque/PLCEXPAND/Evidencia/validacion AI.png

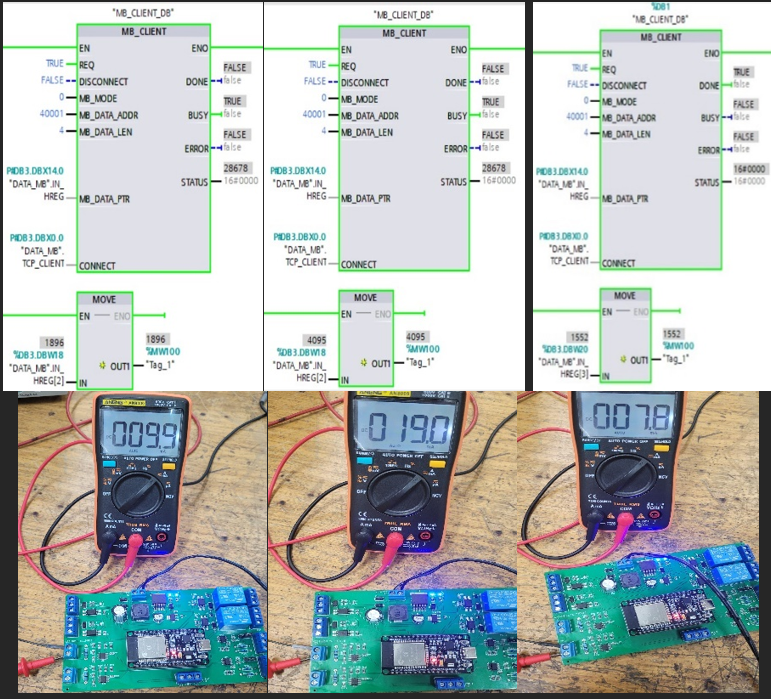
Evidencia/validacion AI.png
