fuque/PLCEXPAND/Evidencia/validacion AO.png

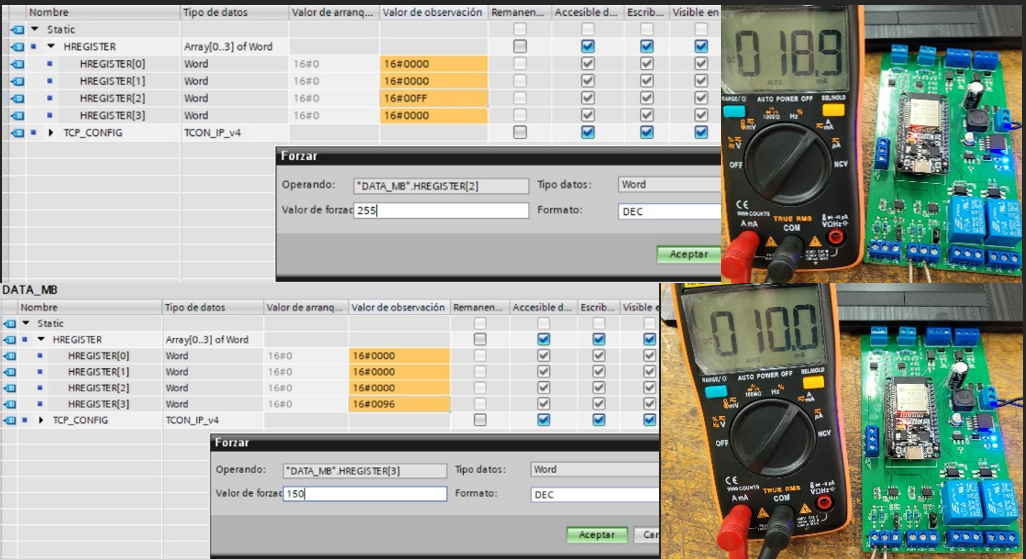
Evidencia/validacion AO.png
