fuque/PLCEXPAND/Evidencia/validacion circuito alimentacion.png

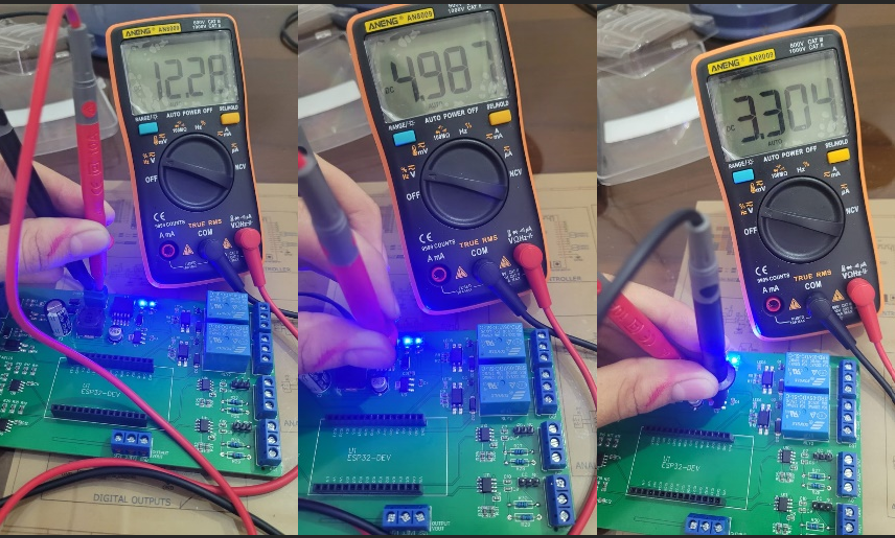
Evidencia/validacion circuito alimentacion.png
