fuque/PLCEXPAND/Evidencia/validacion DI.png

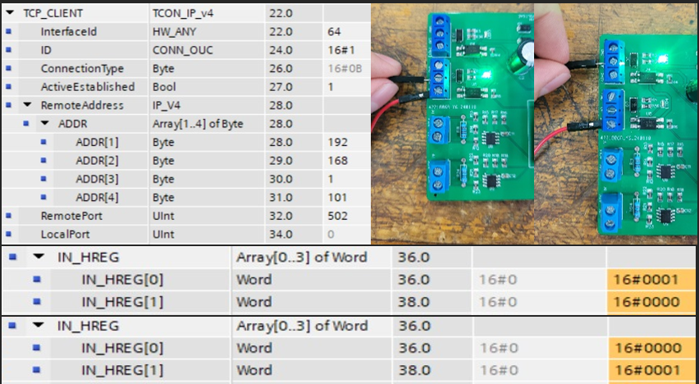
Evidencia/validacion DI.png
