fuque/PLCEXPAND/Evidencia/vista capa inferior.png

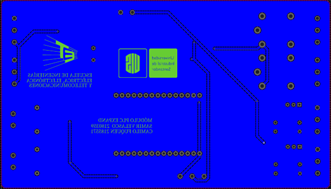
Evidencia/vista capa inferior.png
