fuque/PLCEXPAND/Evidencia/vista capa superior.png

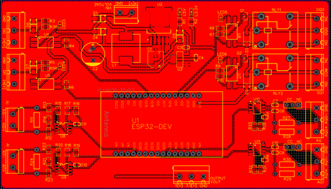
Evidencia/vista capa superior.png
