fuque/PLCEXPAND/Tablas/costos.png

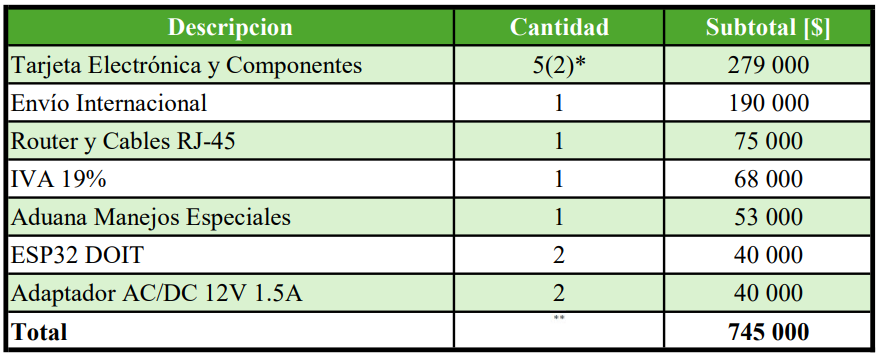
Tablas/costos.png
