fuque/PLCEXPAND/Tablas/modbus en TIA Portal.png

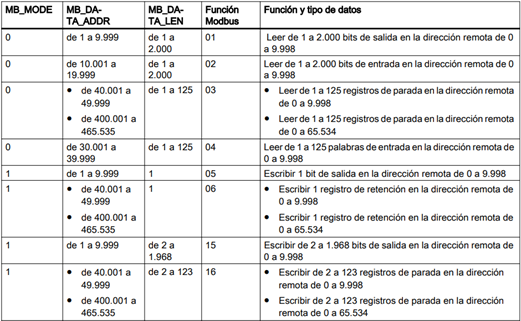
Tablas/modbus en TIA Portal.png
