fuque/PLCEXPAND/Lista de componentes/BOM_PCB_PLCEXPAND222_2024-01-17.csv

ID | Name | Designator | Footprint | Quantity | Manufacturer Part | Manufacturer | Supplier | Supplier Part | Price
1 | 1kΩ | R8,R9,R2,R1,R7,R10,R25,R32 | R0805 | 8 | 0805W8F1001T5E | UNI-ROYAL(厚声) | LCSC | C17513 | $ 0,002
2 | ORH-B36G | LED1,LED2 | LED0603-RD | 2 | ORH-B36G | Orient(奥伦德) | LCSC | C193191 | $ 0,006
3 | TLMS1000-GS08 | LED5,LED6 | LED0603-R-RD | 2 | TLMS1000-GS08 | VISHAY(威世) | LCSC | C241893 | $ 0,101
4 | 10uF | C5,C8,C11,C12,C3,C4 | C0603 | 6 | CL10A106KP8NNNC | SAMSUNG(三星) | LCSC | C19702 | $ 0,006
5 | SRD-05VDC-SL-C | RLY2,RLY1 | RELAY-TH_SRD-XXVDC-XL-C | 2 | SRD-05VDC-SL-C | 松乐 | LCSC | C35449 | $ 0,324
6 | 220uF | C1 | CAP-SMD_BD6.3-L6.6-W6.6-FD | 1 | RVT220UF10V67RV0037 | KNSCHA(科尼盛) | LCSC | C2833309 | $ 0,030
7 | 470uF | C2 | CAP-TH_BD10.0-P5.00-D1.0-FD | 1 | KM477M035G17RR0VH2FP0 | CX(承兴) | LCSC | C2064 | $ 0,057
8 | 100nF | C6,C7,C9,C10 | C0603 | 4 | CL10B104KA8NNNC | SAMSUNG(三星) | LCSC | C1590 | $ 0,003
9 | SS34 | D1,D4,D5,D6,D7 | SMA_L4.2-W2.7-LS5.0-RD | 5 | SS34 | YONGYUTAI(永裕泰) | LCSC | C2909963 | $ 0,030
10 | 1N4004 | D2,D3 | SMA_L4.4-W2.8-LS5.4-RD | 2 | 1N4004 | TWGMC(台湾迪嘉) | LCSC | C727080 | $ 0,009
11 | 47uH | L1 | IND-SMD_L12.0-W12.0_CDRH127XX | 1 | PSPHAQ127-470M | PROD(谱罗德) | LCSC | C2983069 | $ 0,223
12 | ORH-G36G | LED3,LED4 | LED0603-R-RD | 2 | ORH-G36G | Orient(奥伦德) | LCSC | C205443 | $ 0,010
13 | MMBT2222A_C545537 | Q1,Q2 | SOT-23-3_L2.9-W1.3-P1.90-LS2.4-BR | 2 | MMBT2222A | UMW(广东友台半导体) | LCSC | C545537 | $ 0,017
14 | 2kΩ | R3,R3R,R5,R5R,R26,R31 | R0805 | 6 | 0805W8F2001T5E | UNI-ROYAL(厚声) | LCSC | C17604 | $ 0,002
15 | 10kΩ | R4,R6,R12,R13,R14,R15,R16,R19,R20,R21,R22,R23 | R0805 | 12 | 0805W8F1002T5E | UNI-ROYAL(厚声) | LCSC | C17414 | $ 0,001
16 | 100 | R11,R24 | R_AXIAL-0.4 | 2 | MFR-25FTE52-100R | YAGEO(国巨) | LCSC | C172966 | $ 0,012
17 | 15K | R17,R18 | R0805 | 2 | 0805W8F1502T5E | UNI-ROYAL(厚声) | LCSC | C17475 | $ 0,002
18 | 250Ω | R27,R28,R29,R30 | RES-TH_BD2.4-L6.3-P10.30-D0.6 | 4 | RNS14F2500A520NH | 台湾双羽 | LCSC | C274489 | $ 0,009
19 | LM2596SX-5.0/NOPB | U2 | TO-263-5_L10.2-W8.9-P1.70-TL | 1 | LM2596SX-5.0/NOPB | TI(德州仪器) | LCSC | C10002 | $ 1,842
20 | AMS1117-3.3_C347222 | U3 | SOT-223-4_L6.5-W3.5-P2.30-LS7.0-BR | 1 | AMS1117-3.3 | UMW(广东友台半导体) | LCSC | C347222 | $ 0,033
21 | PC817B_C3025163 | U4,U5,U6,U7 | OPTO-SMD-4_L4.6-W6.5-P2.54-LS10.3-TL | 4 | PC817B | GOODWORK(固得沃克) | LCSC | C3025163 | $ 0,041
22 | TP5552-SR | U8,U9 | SO-8_L4.9-W3.9-P1.27-LS5.9-BL | 2 | TP5552-SR | 3PEAK | LCSC | C139523 | $ 2,079
23 | LM358AD | U10,U11 | SOP-8_L4.9-W3.9-P1.27-LS6.0-BL | 2 | LM358AD | ST(意法半导体) | LCSC | C5456123 | $ 1,243
 |  |  |  |  |  |  |  |  | 6,082 | 24328
