fuque/PLCEXPAND/Evidencia/fabricantes de PLC.png

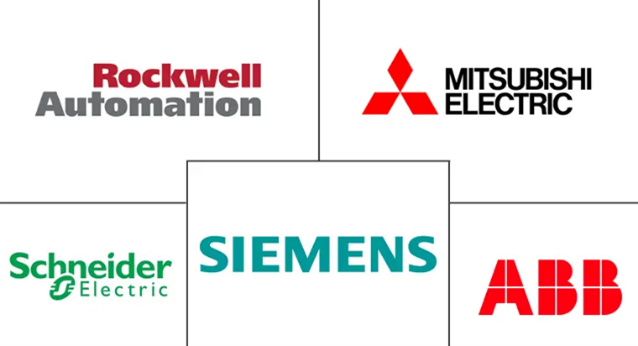
Evidencia/fabricantes de PLC.png
