fuque/PLCEXPAND/(list of files, drawings)

Other design files:
Programas en proteus/ANALOG_IN.pdsprj
Programas en proteus/ANALOG_OUT.pdsprj
Programas en proteus/DIGITAL_IN.pdsprj
Programas en proteus/DIGITAL_OUT.pdsprj
