fuque/PLCEXPAND/(commit log)

2024-03-20 Create Schematic
2024-03-20 Add files via upload
    Esquema general del diseño de la tarjeta.
2024-03-31 Create arduino
2024-04-11 Create Archivo de fabricación
